kfranky/Arduino-BOT_Mover1/README.md

# Arduino-BOT_Mover1
ardu

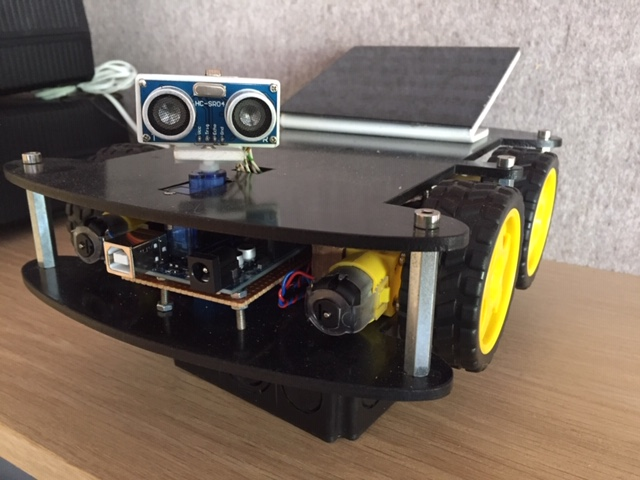
[picture p1: Botmov.JPG]
BOT


## Stückliste:

- 1 Arduino NANO
- 4 Getriebemotoren mit Räder
- 1 Dual-H-Brücke-DC-Schrittmotorantrieb L298N
- 1 Ultraschallmodul HC-SR04 
- 1 IKY-022 IR Empfänger CHQ1838 Sensor mit Fernbedienung
- 2 ABS Platten Kunststoff 29x21cm 4mm dick
- 2 18650 Akkus mit Akkucase
- Kleinmaterial, Schrauben, Muttern, Klemmen, Draht
- Platinenhalter
- Optional: Solarpanel für die Akku-Ladung

## Links:

- Download Inkscape (*.svg): [Link](https://inkscape.org/de/release/inkscape-1.0.1) 

- Downlaod Arduino (*.ino): [Link](https://www.arduino.cc/en/Main/Software)

- Arbeitsschritte Arduino BOT-Mover: [Link](https://github.com/frankyhub/Arduino-BOT_Mover1/blob/master/Arbeitsschritte%20Arduino%20Bot.pdf)

- Deck- und Bodenplatte (SVG-File): [Link](https://github.com/frankyhub/Arduino-BOT_Mover1)

- Platinenhalter: [Link](https://github.com/frankyhub/openscad-Beispiele/tree/master/008%20Platinenhalter)

- Schaltplan: [Link](https://github.com/frankyhub/Arduino-BOT_Mover1/blob/master/Schaltplan%20Nano%20V2.pdf)

- Arduino Programm: [Link](https://github.com/frankyhub/Arduino-BOT_Mover1/blob/master/Mover1_V1-ARDUINO_Files.zip)
