kfranky/Arduino-BOT_Mover1/Schaltplan Nano V2.pdf

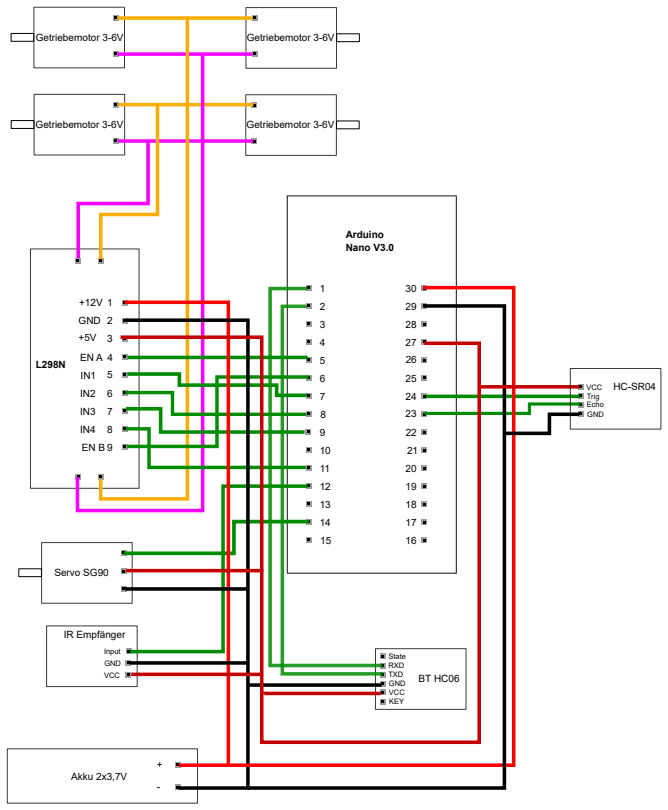
[picture p14: figure]
Getriebemotor 3-6V; +12V GND +5V EN A IN1 IN2 IN3 IN4; Arduino Nano V3.0; Akku 2x3,7V; Servo SG90; VCC Trig Echo GND; State RXD TXD GND VCC KEY; IR Empfänger; Input GND VCC

3 4 5 | 28 27 26 25 24 23 22 21 20 19 18 17 16

# Schaltplan BOT-Mover1
